LAMPA23/AD---Clock/ПЕ.pdf

Справ. № | Перв. застосув.

Поз.
позначе
ння
Найменування | Кіл. | Примітки

# ДК91с.466369.007 ПЕ3

Зм. | Арк. | № докум. | Підп. | Дата
Розраб. | Тисяк Є.В. | | | Цифровий годинник Перелік елементів | Літ. | Аркуш | Аркушів
Перев. | Адаменко І.О. | | | | | | | 1 | 2
КПІ ім. Ігоря Сікорського, ФЕЛ, КЕОА, ДК-91

Н.контр.
Затв. | Губар В.Г.
Інв. № подл. | Підп. та дата | Взам. інв. № | Інв. № дубл. | Підп. та дата
| Конденсатори
C1,C2 | C-0805 16 В 0,033 мкФ 5% X5R Jiayang | 2
C3 | C-0805 16 В 91 мкФ 5% X5R Jiayang | 1
C4 | C-0805 16 В 0,047 мкФ 5% X5R Jiayang | 1
| Мікросхеми
DD1 | SN7490A Texas Instruments | 1
DD2 | CD4011 Texas Instruments | 1
DD3 | SN7492A Texas Instruments | 1
DD4 | SN7490A Texas Instruments | 1
DD5 | K155ИЕ1 Ukraine | 1
DD6 | SN7492A Texas Instruments | 1
DD7 | K155ИЕ1 Ukraine | 1
DD8 | SN7490A Texas Instruments | 1
DD9, DD10 | K155ИЕ1 Ukraine | 2
DD11 | SN7493 Texas Instruments | 1
DD12 | K155ИЕ1 Ukraine | 1

Поз.
позначе
ння
Найменування | Кіл. | Примітки

# ДК91с.466369.007ПЕ3

Арк.

Зм. | Арк. | № докум. | Підп. | Дата | 2
Інв. № подл. | Підп. та дата | Взам. інв. № | Інв. № дубл. | Підп. та дата

Резистори

R1,R2 | R-0805 0,125 Вт 6,8 кОм 5% Vishay | 2
R3-R5 | R-0805 0,125 Вт 2 кОм 5% Vishay | 3
| Кнопки
SB1-SB3 | TS3611-2.5-180-B KLS | 3
| Роз'єми
XS1-XS3 | Pins | 3
XS4 | Power | 1
XS5-XS7 | Pins | 3
| Кварцові резонатори
ZQ1 | SIT1579AC-J3-33E-0001.000000 SiTime | 1

R89
