LAMPA23/AD---Clock/Специфікація.pdf

Справ. № | Перв. застосув.

Формат Зона Позиція
Позначення | Найменування | Кіл.

Примітки

# ДК91.466369.007СП

Зм. | Арк. | № докум. | Підп. | Дата
Розроб. | Тисяк Є.В. | | | Цифровий годинник Специфікація | Літ. | Аркуш | Аркушів
Перев. | Адаменко І.О. | | | | | | | 1 | 2
КПІ ім. Ігоря Сікорського, ФЕЛ, КЕОА

Н.контр.
Затв. | Губар В.Г.
Інв. № подл. | Підп. та дата | Взам. інв. № | Інв. № дубл. | Підп. та дата
| | Документація
А4 | ДК91.466369.007 СП | Специфікація | 2 | *цей документ
А3 | ДК91.466369.007 СК | Складальне креслення | 1
А3 | ДК91с.466369.007 Е3 | Схема електрична принципова | 1
А4 | ДК91с.466369.007 ПЕ3 | Перелік елементів | 2
А4 | ДК91.466369.007 ПЗ | Пояснювальна записка | 50
| | | Деталі
А3 | 1 | ДК91.758755.007 ДП | Плата друкована | 1
| Мікросхеми
2 | K155ИЕ1 Ukraine | 5 | DD5, 7, 9, 10 ,12
3 | SN7490A Texas Instruments | 3 | DD1, DD4, DD8
4 | SN7492A Texas Instruments | 2 | DD3, DD6
5 | SN7493 Texas Instruments | 1 | DD11
6 | CD4011 Texas Instruments | 1 | DD2
| Конденсатори
7 | C-0805 16 В 0,033 мкФ 5% X5R Jiayang | 2 | C1,C2
8 | C-0805 16 В 91 мкФ 5% X5R Jiayang | 1 | C3
9 | C-0805 16 В 91 мкФ 5% X5R Jiayang | 1 | C4

Формат
Зона

Позиція
Позначення | Найменування | Кіл.

Примітка

# ДК91.466369.007СП

Арк.

Зм. | Арк. | № докум. | Підп. | Дата | 2
Інв. № подл. | Підп. та дата | Взам. інв. № | Інв. № дубл. | Підп. та дата
| Резистори
10 | R-0805 0,125 Вт 6,8 кОм 5% Vishay | R1, R2
11 | R-0805 0,125 Вт 2 кОм 5% Vishay | R3-R5
| Роз'єми
12 | Pins | XS1-3, XS5-7
13 | Power | XS4
| Кнопки
14 | TS3611-2.5-180-B KLS | 3 | SB1-SB3
| Кварцові резонатори
15 | SIT1579AC-J3-33E-0001.000000 SiTime | 1 | ZQ1
