LAMPA23/AD---Clock/ДП.pdf

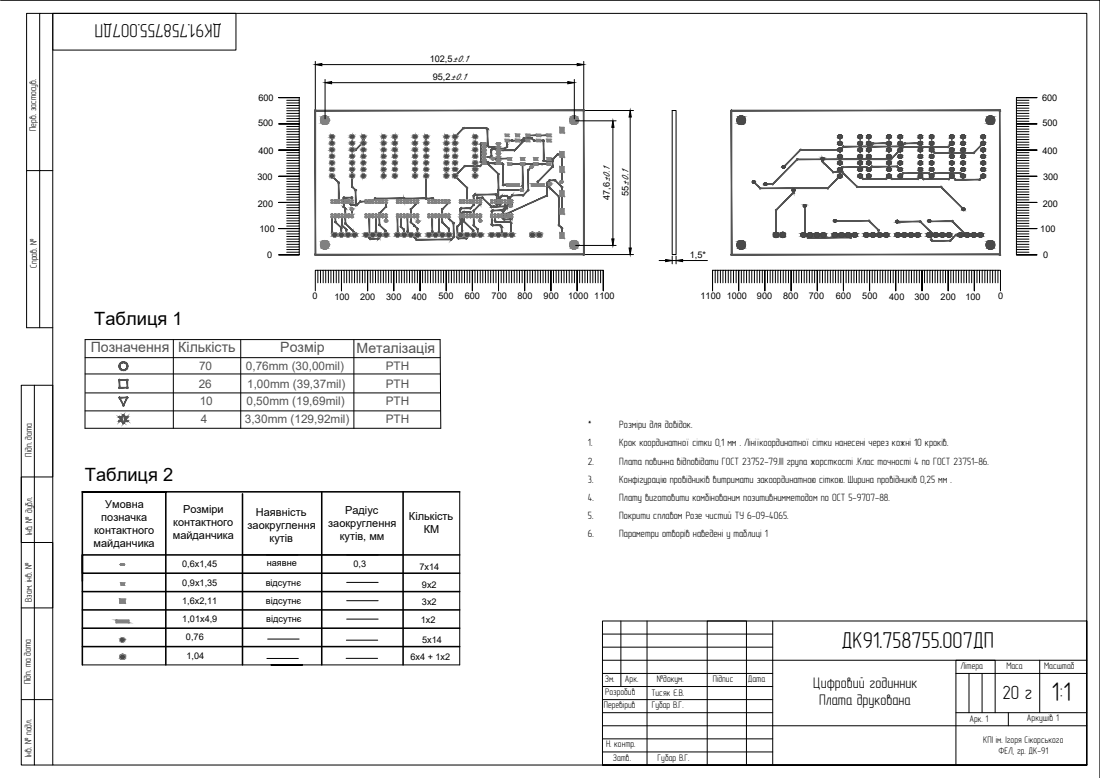
[picture p18: page 1]
Цифровий годинник Плата друкована; Літера; Маса; Масштаб; Арк. 1; Аркушів 1; Розміри для довідок.; Металізація PTH PTH PTH PTH; Розмір 0,76mm (30,00mil) 1,00mm (39,37mil) 0,50mm (19,69mil) 3,30mm (129,92mil); Кількість 70 26 10 4; Позначення; Умовна позначка контактного майданчика; Розміри контактного майданчика; Наявність заокруглення кутів; Радіус заокруглення кутів, мм; Кількість КМ; Таблиця 2; Таблиця 1; наявне; відсутнє відсутнє відсутнє

Інв. № подл. Підп. та дата Взам. інв. № Інв. № дубл. Підп. дата Справ. № Перв. застосув.

1. Крок координатної сітки 0,1 мм . Лініїкоординатної сітки нанесені через кожні 10 кроків.
2. Плата повинна відповідати ГОСТ 23752-79.III група жорсткості .Клас точності 4 по ГОСТ 23751-86.
3. Конфігурацію провідників витримати закоординатною сіткою. Ширина провідників 0,25 мм .
4. Плату виготовити комбінованим позитивнимметодом по ОСТ 5-9707-88.
5. Покрити сплавом Розе чистий ТУ 6-09-4065.
6. Параметри отворів наведені у таблиці 1

Зм. | Арк. | №докум. Підпис Дата
Розробив | | Тисяк Є.В.
Перевірив | | Губар В.Г.

КПІ ім. Ігоря Сікорського ФЕЛ, гр. ДК-91

Н. контр.
Затв. | Губар В.Г.
