LAMPA23/AD---Clock/ЕЗ.PDF

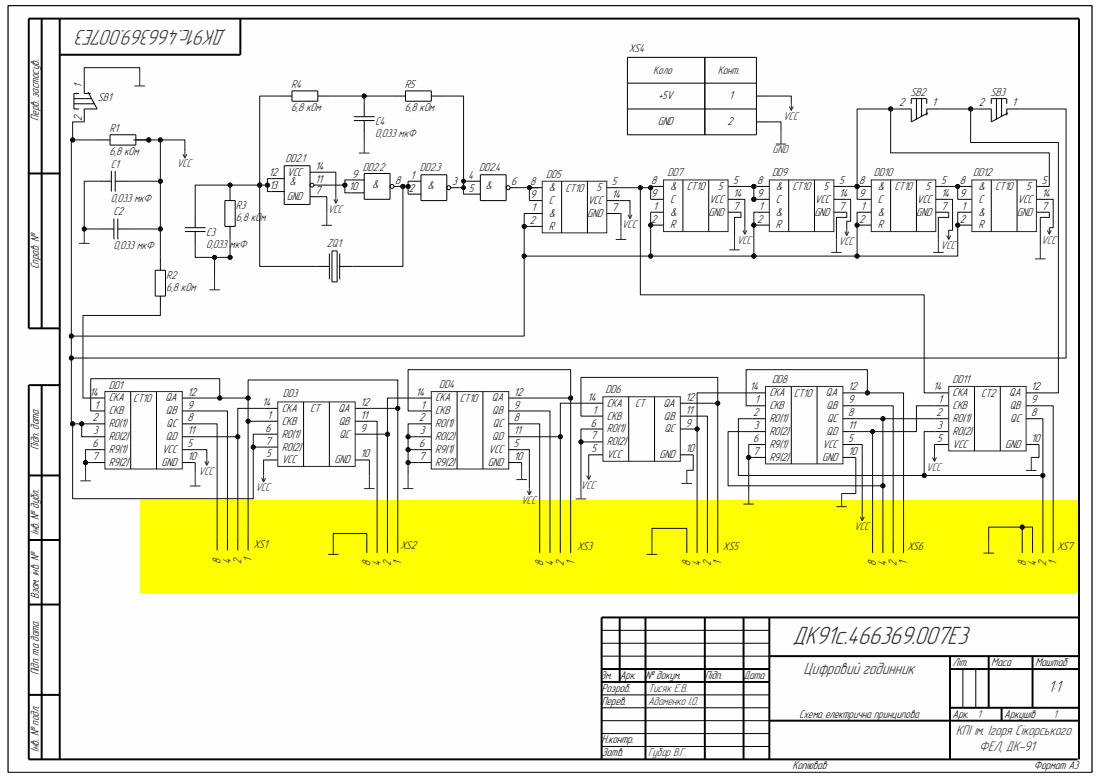
[picture p19: page 1]

XS4
Коло | Конт.

Цифровий годинник Інв. № подл. Підп. та дата Взам. інв. № Інв. № дубл. Підп. дата Справ. № Перв. застосув.

GND | 2

Схема електрична принципова | Літ. | Маса | Маштаб

Зм. | Арк. | № докум. | Підп. | Дата | | | | | 1:1
Розроб. | | Тисяк Є.В.
Перев. | | Адаменко І.О.

Арк. 1 1 | Аркушів
КПІ ім. Ігоря Сікорського ФЕЛ, ДК-91

Н.контр.
Затв. | Губар В.Г.
