LAMPA23/AD---Clock/СК.pdf

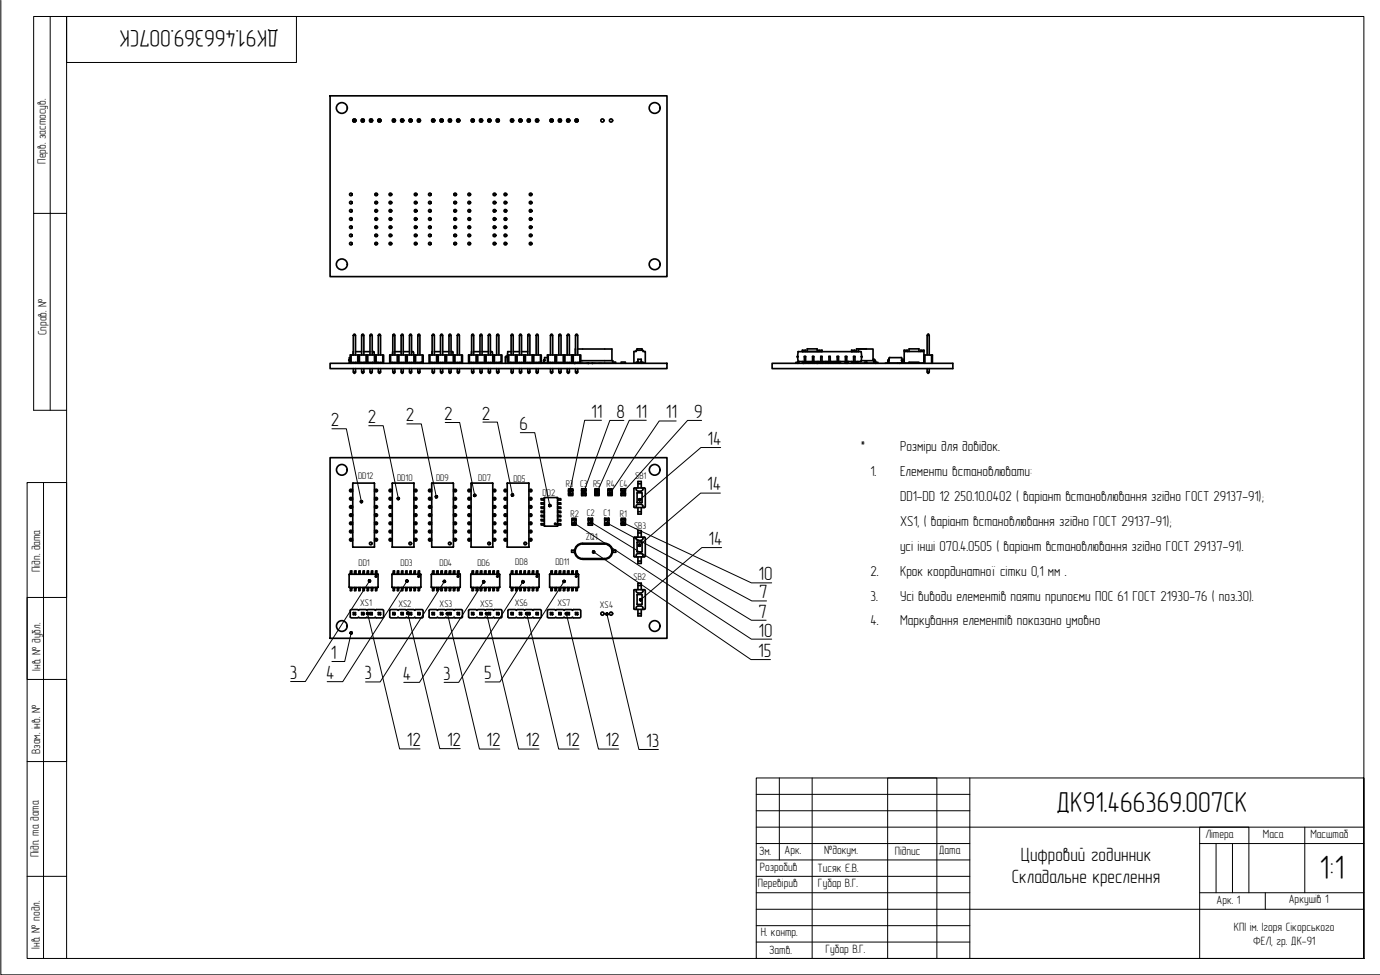
[picture p20: page 1]
Арк.; №докум.; Підпис; Дата Розробив; Перевірив Н. контр. Затв.; Губар В.Г. Губар В.Г. Тисяк Є.В.; Цифровий годинник Складальне креслення; Літера; Маса; Масштаб Арк. 1; Аркушів 1 1:1 КПІ; ім. Ігоря Сікорського ФЕЛ, гр. ДК-91 ДК91.466369.007СК

Справ. № Перв. застосув. 7СК .00 466369 91. ДК 21 3 DD12 DD10 DD9 DD7 DD5 DD2 R3 SB1 XS1 XS2 XS3 XS5 XS6 XS7 XS4 DD1 DD3 DD4 DD6 DD8 DD11 С3 С4 R2 С2 С1 R5 R4 R1 SB3 SB2 ZQ1 2 2 2 2 4 3 4 3 5 12 6 11 8 11 11 9 141414 10771015 12 12 12 12 12 13 * Розміри для довідок. 1. Елементи встановлювати: DD1-DD 12 250.10.0402 ( варіант встановлювання згідно ГОСТ 29137-91); XS1, ( варіант встановлювання згідно ГОСТ 29137-91); усі інші 070.4.0505 ( варіант встановлювання згідно ГОСТ 29137-91). 2. Крок координатної сітки 0,1 мм . 3. Усі виводи елементів паяти припоєми ПОС 61 ГОСТ 21930-76 ( поз.30). 4. Маркування елементів показано умовно

Інв. № подл. Підп. та дата Взам. інв. № Інв. № дубл. Підп. дата
