LAMPA23/AD---Clock/(list of files, drawings)

Other design files:
AD project/AD project.PrjPcb
AD project/PCB1.PcbDoc
AD project/PcbLib1.PcbLib
AD project/Schlib1.SchLib
AD project/Sheet1.SchDoc
